recursivenomad/picoprobe-candybar/(list of files, cad)

Other CAD files:
enclosure/picoprobe-candybar.FCStd
