recursivenomad/picoprobe-candybar/pcb/picoprobe-candybar.kicad_sch

## KiCad design pcb/picoprobe-candybar.kicad_sch (2024-10-31, an earlier design)

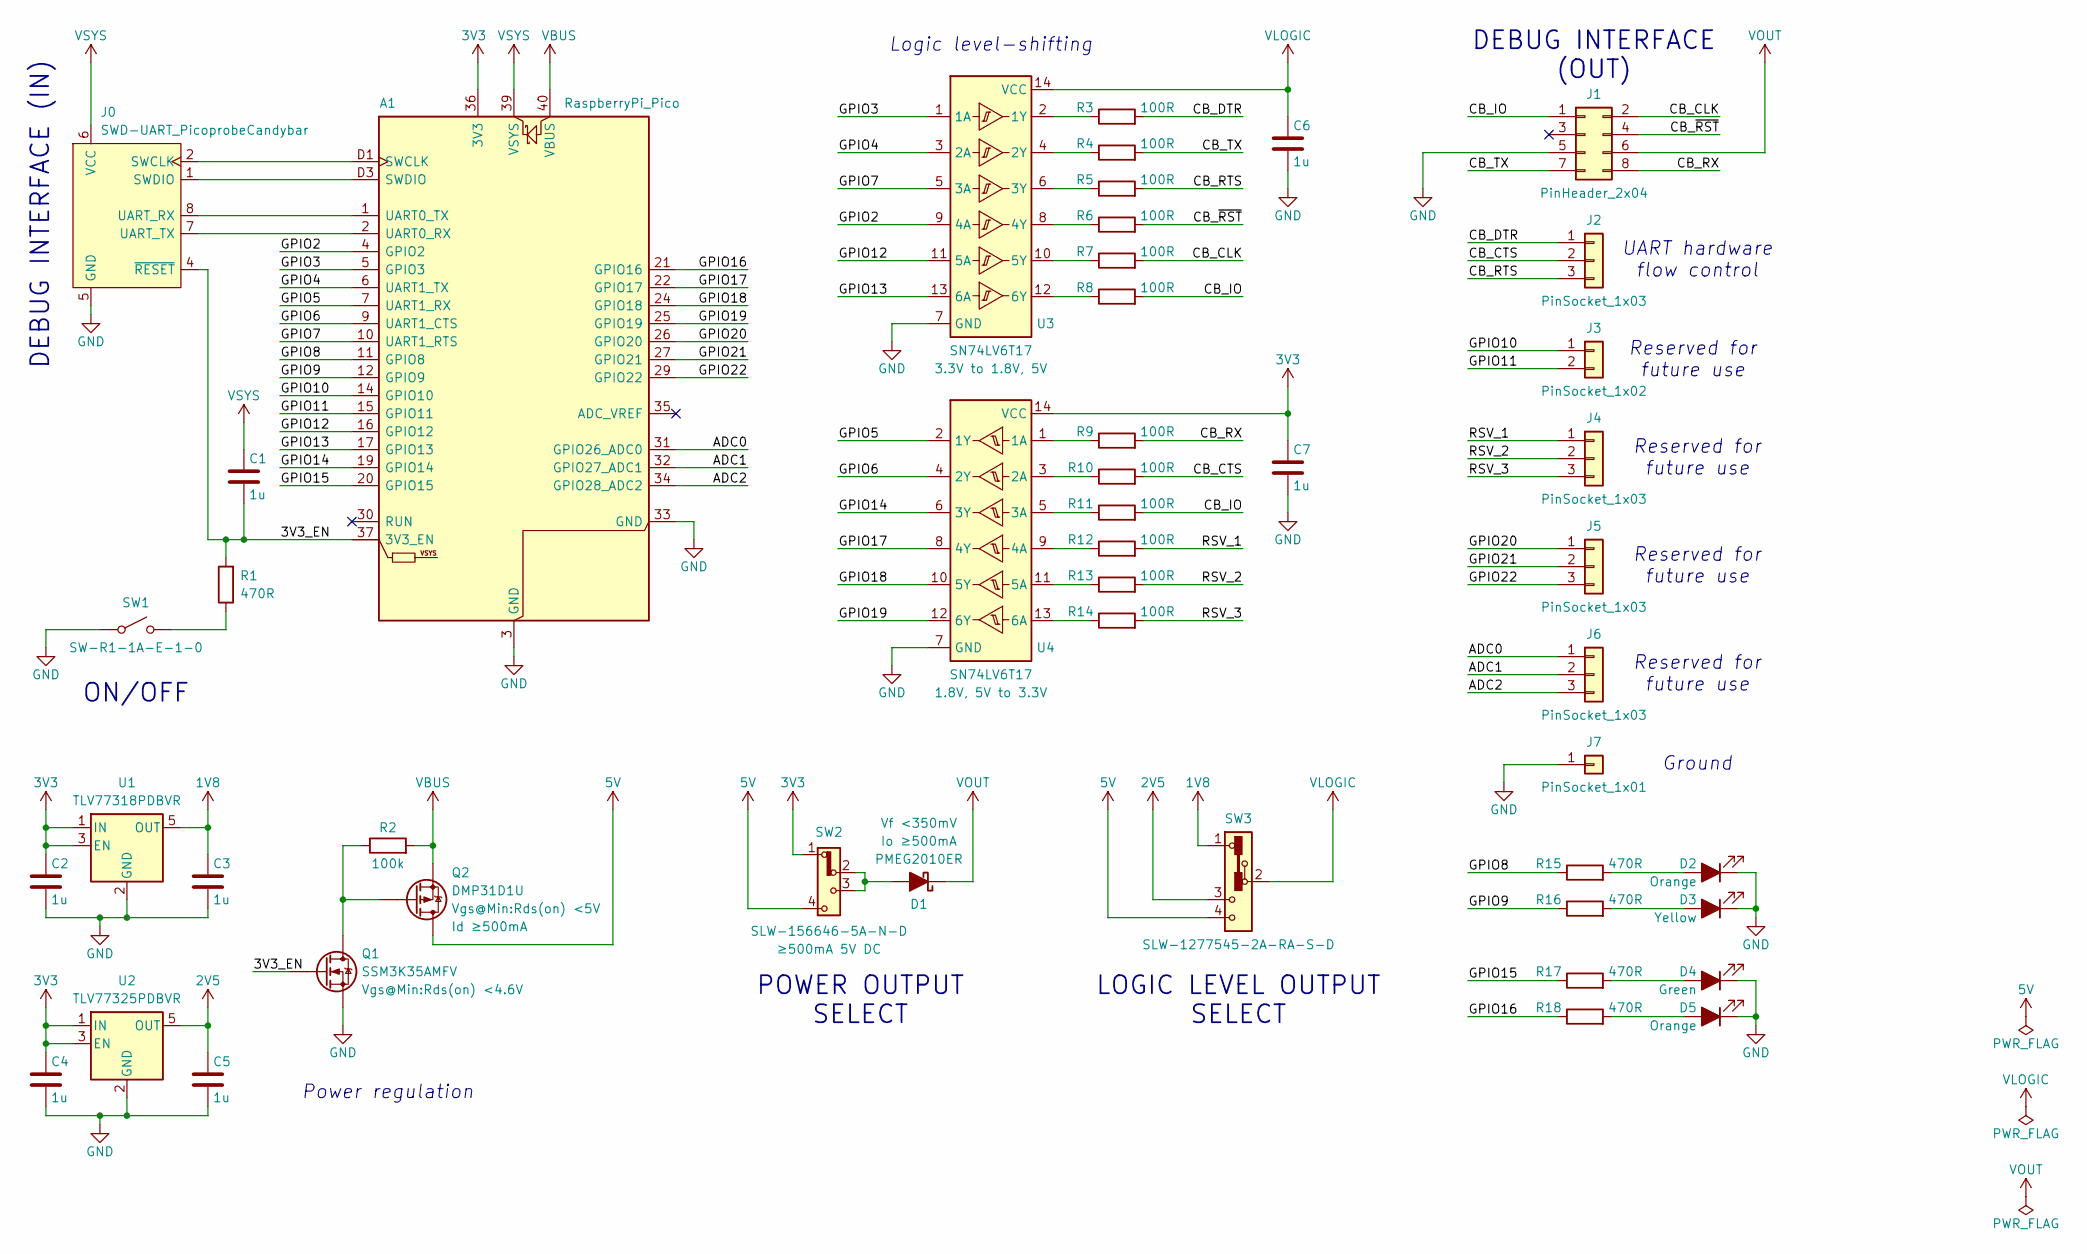
[picture p1: schematic picoprobe-candybar.kicad_sch]

Parts:
A1: RaspberryPi_Pico; RaspberryPi_Pico_Original_SMD_HandSolder
C1, C2, C3, C4, C5, C6, C7: 1u; C_0805_2012Metric_Pad1.18x1.45mm_HandSolder
D1: PMEG2010ER; Nexperia_CFP3_SOD-123W
D2, D5: Orange; LED_0805_2012Metric_Pad1.15x1.40mm_HandSolder
D3: Yellow; LED_0805_2012Metric_Pad1.15x1.40mm_HandSolder
D4: Green; LED_0805_2012Metric_Pad1.15x1.40mm_HandSolder
J0: SWD-UART_PicoprobeCandybar; SWD-UART_PicoprobeCandybar_2Rows_7Pins_P2.54mm_Polarized_Pr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
J1: PinHeader_2x04; PinHeader_2x04_P2.54mm_Vertical
J2, J4, J5, J6: PinSocket_1x03; PinSocket_1x03_P2.54mm_Horizontal
J3: PinSocket_1x02; PinSocket_1x02_P2.54mm_Horizontal
J7: PinSocket_1x01; PinSocket_1x01_P2.54mm_Horizontal
Q1: SSM3K35AMFV; SOT-723
Q2: DMP31D1U; SOT-23-3
R1, R15, R16, R17, R18: 470R; R_0805_2012Metric_Pad1.20x1.40mm_HandSolder
R2: 100k; R_0805_2012Metric_Pad1.20x1.40mm_HandSolder
R3, R4, R5, R6, R7, R8, R9, R10, R11, R12, R13, R14: 100R; R_0805_2012Metric_Pad1.20x1.40mm_HandSolder
SW1: SW-R1-1A-E-1-0; SW_Rocker_SPST_QuickConnect_P10.8mm_SW-R1-1X-E-XX-0_Retrofi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
SW2: SLW-156646-5A-N-D; SW_Slide_SP3T_Vertical_P3.2mm_CUI_SLW-156646-5A-N-D
SW3: SLW-1277545-2A-RA-S-D; SW_Slide_SP3T_Common_Horizontal_P2mm_CUI_SLW-1277545-2A-RA-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
U1: TLV77318PDBVR; SOT-23-5
U2: TLV77325PDBVR; SOT-23-5
U3, U4: SN74LV6T17; TSSOP-14_4.4x5mm_P0.65mm

Connections:
1V8: C3.1, SW3.1, U1.5 (OUT)
2V5: C5.1, SW3.3, U2.5 (OUT)
3V3: A1.36 (3V3), C2.1, C4.1, C7.1, SW2.1, U1.1 (IN), U1.3 (EN), U2.1 (IN), U2.3 (EN), U4.14 (VCC)
5V: Q2.3 (D), SW2.4, SW3.4
ADC0: A1.31 (GPIO26_ADC0), J6.1
ADC1: A1.32 (GPIO27_ADC1), J6.2
ADC2: A1.34 (GPIO28_ADC2), J6.3
CB_CLK: J1.2, R7.2
CB_CTS: J2.2, R10.2
CB_DTR: J2.1, R3.2
CB_IO: J1.1, R8.2, R11.2
CB_RTS: J2.3, R5.2
CB_RX: J1.8, R9.2
CB_TX: J1.7, R4.2
CB_~RST: J1.4, R6.2
GND: A1.3 (GND), A1.8 (GND), A1.13 (GND), A1.18 (GND), A1.23 (GND), A1.28 (GND), A1.33 (AGND), A1.38 (GND), A1.D2 (GND), C2.2, C3.2, C4.2, C5.2, C6.2, C7.2, D2.1 (K), D3.1 (K), D4.1 (K), D5.1 (K), J0.5 (GND), J1.5, J7.1, Q1.2 (S), SW1.1 (A), U1.2 (GND), U2.2 (GND), U3.7 (GND), U4.7 (GND)
GPIO2: A1.4 (GPIO2), U3.9 (4A)
GPIO3: A1.5 (GPIO3), U3.1 (1A)
GPIO4: A1.6 (GPIO4), U3.3 (2A)
GPIO5: A1.7 (GPIO5), U4.2 (1Y)
GPIO6: A1.9 (GPIO6), U4.4 (2Y)
GPIO7: A1.10 (GPIO7), U3.5 (3A)
GPIO8: A1.11 (GPIO8), R15.1
GPIO9: A1.12 (GPIO9), R16.1
GPIO10: A1.14 (GPIO10), J3.1
GPIO11: A1.15 (GPIO11), J3.2
GPIO12: A1.16 (GPIO12), U3.11 (5A)
GPIO13: A1.17 (GPIO13), U3.13 (6A)
GPIO14: A1.19 (GPIO14), U4.6 (3Y)
GPIO15: A1.20 (GPIO15), R17.1
GPIO16: A1.21 (GPIO16), R18.1
GPIO17: A1.22 (GPIO17), U4.8 (4Y)
GPIO18: A1.24 (GPIO18), U4.10 (5Y)
GPIO19: A1.25 (GPIO19), U4.12 (6Y)
GPIO20: A1.26 (GPIO20), J5.1
GPIO21: A1.27 (GPIO21), J5.2
GPIO22: A1.29 (GPIO22), J5.3
InternalPullUp_3V3_EN: A1.37 (3V3_EN), C1.2, J0.4 (~RESET), Q1.1 (G), R1.2
unnamed: A1.1 (GPIO0), J0.8 (UART_RX)
unnamed: A1.2 (GPIO1), J0.7 (UART_TX)
unnamed: A1.D1 (SWCLK), J0.2 (SWCLK)
unnamed: A1.D3 (SWDIO), J0.1 (SWDIO)
unnamed: D1.2 (A), SW2.2, SW2.3
unnamed: D2.2 (A), R15.2
unnamed: D3.2 (A), R16.2
unnamed: D4.2 (A), R17.2
unnamed: D5.2 (A), R18.2
unnamed: Q1.3 (D), Q2.1 (G), R2.1
unnamed: R1.1, SW1.2 (B)
unnamed: R3.1, U3.2 (1Y)
unnamed: R4.1, U3.4 (2Y)
unnamed: R5.1, U3.6 (3Y)
unnamed: R6.1, U3.8 (4Y)
unnamed: R7.1, U3.10 (5Y)
unnamed: R8.1, U3.12 (6Y)
unnamed: R9.1, U4.1 (1A)
unnamed: R10.1, U4.3 (2A)
unnamed: R11.1, U4.5 (3A)
unnamed: R12.1, U4.9 (4A)
unnamed: R13.1, U4.11 (5A)
unnamed: R14.1, U4.13 (6A)
RSV_1: J4.1, R12.2
RSV_2: J4.2, R13.2
RSV_3: J4.3, R14.2
VBUS: A1.40 (VBUS), Q2.2 (S), R2.2
VLOGIC: C6.1, SW3.2, U3.14 (VCC)
VOUT: D1.1 (K), J1.6
VSYS: A1.39 (VSYS), C1.1, J0.6 (VCC)

Notes on the sheet:
POWER OUTPUT SELECT
Ground
Reserved for future use
DEBUG INTERFACE (IN)
LOGIC LEVEL OUTPUT SELECT
Power regulation
ON/OFF
DEBUG INTERFACE (OUT)
Logic level-shifting
UART hardware flow control
