recursivenomad/picoprobe-candybar/firmware/src/candybar_hook.c

/* SPDX-License-Identifier: MIT-0 OR CC0-1.0 *\
\*    Authored 2024 by Peter S. Hollander    */


/*
   debugprobe calls bi_decl_config() from the top of main().
   We point to _this_ file in our CMakeLists.txt - both to add custom binary
   declarations, but also to hook into the start of execution and inject our
   own features on top of debugprobe's, without modifying its source.
*/


#include "pico_binary_license_info.h"

#include "DAP_config.h"
#include "probe_config.h"

#include "DAP.h"

#include "hardware/gpio.h"
#include "pico/binary_info.h"

#include <stdbool.h>
#include <stdint.h>


#define STR_LITERAL(x) #x
#define STR(x) STR_LITERAL(x)


#define DHCSR_DBGKEY      0xA05F
#define DHCSR_C_DEBUGEN  (1U << 0)
#define DHCSR_C_HALT     (1U << 1)


static const uint8_t HaltInjectionBuffer[] = {
        ID_DAP_Transfer,                // DAP_ProcessCommand() ID; incremented in switch()
        0x00,                           // DAP_SWD_Transfer() "Ignore DAP index" ?
        0x01,                           // DAP_SWD_Transfer() request_count
        DAP_TRANSFER_APnDP,             // DAP_SWD_Transfer() request_value
        DHCSR_C_DEBUGEN | DHCSR_C_HALT, // DAP_SWD_Transfer() data [7:0]
        0x00,                           //                    data [15:8]
        (uint8_t)(DHCSR_DBGKEY),        //                    data [23:16]
        (uint8_t)(DHCSR_DBGKEY >> 8)    //                    data [31:24]
    };


void DAP_inject_halt_callback(unsigned int gpio, unsigned long event_mask) {
    // TODO: Is this interrupt safe if another transfer is already in progress?
    // TODO: Is this interrupt safe if another interrupt occurs during it?

    // Ignore unused parameters defined by gpio_irq_callback_t typedef
    (void) gpio;
    (void) event_mask;

    uint8_t ThrowawayReceiveBuffer[DAP_PACKET_COUNT];
    DAP_ProcessCommand(HaltInjectionBuffer, ThrowawayReceiveBuffer);
}


void candybar_hook(void) {
    // These pulls will weakly influence the target circuit
    gpio_pull_down(PROBE_PIN_IRQ_RISING);
    gpio_pull_up(PROBE_PIN_IRQ_FALLING);

    gpio_set_irq_enabled_with_callback(PROBE_PIN_IRQ_RISING, GPIO_IRQ_EDGE_RISE, true, &DAP_inject_halt_callback);
    gpio_set_irq_enabled_with_callback(PROBE_PIN_IRQ_FALLING, GPIO_IRQ_EDGE_FALL, true, &DAP_inject_halt_callback);
}


void bi_decl_config(void) {

    candybar_hook();

    bi_decl(bi_1pin_with_name(PROBE_PIN_SWCLK, "PROBE SWCLK"));
    bi_decl(bi_1pin_with_name(PROBE_PIN_SWDIO, "PROBE SWDIO"));
    bi_decl(bi_1pin_with_name(PROBE_PIN_SWDI,  "PROBE SWDI" ));
    bi_decl(bi_1pin_with_name(PROBE_PIN_RESET, "PROBE RESET"));

    bi_decl(bi_1pin_with_name(PROBE_UART_TX, "PROBE UART_TX"));
    bi_decl(bi_1pin_with_name(PROBE_UART_RX, "PROBE UART_RX"));

    bi_decl(bi_1pin_with_name(PROBE_UART_CTS, "PROBE UART_CTS"));
    bi_decl(bi_1pin_with_name(PROBE_UART_RTS, "PROBE UART_RTS"));
    bi_decl(bi_1pin_with_name(PROBE_UART_DTR, "PROBE UART_DTR"));

    bi_decl(bi_1pin_with_name(PROBE_USB_CONNECTED_LED, "LED_USB_CONN"));
    bi_decl(bi_1pin_with_name(PROBE_DAP_CONNECTED_LED, "LED_DAP_CONN"));
    bi_decl(bi_1pin_with_name(PROBE_DAP_RUNNING_LED,   "LED_DAP_RUN" ));
    bi_decl(bi_1pin_with_name(PROBE_UART_TX_LED,       "LED_UART_TX" ));
    bi_decl(bi_1pin_with_name(PROBE_UART_RX_LED,       "LED_UART_RX" ));

    // picotool lists bi_decl's of each category in reverse order
    bi_decl(bi_program_feature(STR(PROBE_UART_BAUDRATE) " baud probe UART"));
    bi_decl(bi_program_feature("Activity indicator LEDs"));
    bi_decl(bi_program_feature("Probe target reset support"));

    bi_decl(bi_program_author("Firmware derived from Raspberry Pi's Debug Probe"));
    bi_decl(bi_program_author("Peter S. Hollander <recursivenomad@protonmail.com>"));

    bi_decl(bi_program_license("See repository or accompanying .TXT for complete notices"));
    bi_decl(bi_program_license("MIT-0 OR CC0-1.0, BSD-3-Clause, MIT, Apache-2.0, SunPro, OAR, BSD-4.3TAHOE, Martin-Birgmeier"));

}


#undef STR
#undef STR_LITERAL
