recursivenomad/picoprobe-candybar/(commit log)

2024-06-22 Initialize KiCad project
    KiCad 8.0.3
    [picoprobe-candybar.kicad_pcb, picoprobe-candybar.kicad_sch]
2024-06-23 Add ki-lime-pi-to-go submodule
    Ki-Lime Pi Pico 2.0.0
2024-06-23 Register Raspberry Pi Pico library
2024-06-25 Add kicad-title-block submodule
2024-06-25 Register compact-title-block
    [picoprobe-candybar.kicad_pcb, picoprobe-candybar.kicad_sch]
2024-06-30 Embrace Ki-Lime Pi Pico library name
2024-06-30 Update Ki-Lime Pi Pico to include CC0 dual license
2024-06-30 Update kicad-title-block for standardized license
2024-07-03 Add debugprobe submodule
    Debug Probe v2.0.1
2024-07-03 Create binary-equivalent build process
    Building from firmware/CMakeLists.txt should produce an identical uf2
    when compared to building debugprobe with default settings.
    The creation of a custom CMakeLists.txt and candybar_binary_config.c
    avoids touching any of the unlicensed files distributed by the
    debugprobe repository, while still giving us a starting point of
    building identical binaries.
    [candybar_binary_config.c]
2024-07-03 Add Debug Probe config override
2024-07-03 Override with definitions specific to Candybar
    - Adding target reset support
    - Using the onboard LED for USB indication
    - Applying a custom USB device name
    [board_debug_probe_config.h]
2024-07-03 Remove existing UART feature descriptions
2024-07-06 Fix Ki-Lime Pi Pico library paths
2024-07-26 Update Ki-Lime Pi Pico to 2.1.1
2024-07-26 Don't track a specific branch for Ki-Lime Pi Pico
2024-07-29 Add Raspberry Pi Pico
    [picoprobe-candybar.kicad_sch]
2024-07-29 Add IDC cable connector
    [picoprobe-candybar.kicad_sch]
2024-07-29 Add Picoprobe Candybar debugger interface
    [picoprobe-candybar.kicad_sch]
2024-07-29 Add 74AUP1T17 per Debug Probe schematic
    <https://assets.nexperia.com/documents/data-sheet/74AUP1T17.pdf>
    <https://datasheets.raspberrypi.com/debug/raspberry-pi-debug-probe-schematics.pdf>
2024-07-29 Add all supplemental Debug Probe components
    Identified by comparing against the Pico schematic
    <https://datasheets.raspberrypi.com/pico/pico-datasheet.pdf#pico-schematic>
    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
    [picoprobe-candybar.kicad_sch]
2024-07-29 Initial IDC connector layout
    [picoprobe-candybar.kicad_sch]
2024-07-29 Initial SWD pins layout
    [picoprobe-candybar.kicad_sch]
2024-07-29 Duplicate to create UART pins
    [picoprobe-candybar.kicad_sch]
2024-07-29 Reposition SWD/UART group
    [picoprobe-candybar.kicad_sch]
2024-07-29 Connect Pico & (debugger's own) debug interface
    [picoprobe-candybar.kicad_sch]
2024-07-29 ERC: Don't short VSYS/VBUS
    [picoprobe-candybar.kicad_sch]
2024-07-29 Add schottkey rectifier to match VSYS/VBUS diode
    See D1 from Pico schematic:
    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
2024-07-29 Centre diode symbol
    Technically "off-grid" to KLC, but follows convention of other diodes
2024-07-29 Add VBUS/VCC connection w/ protection diode
    Also adds power flag to accommodate ERC after diode
    (off-page for cleaner exported schematics)
    [picoprobe-candybar.kicad_sch]
2024-07-29 ERC: Replace colliding label with non-label text
    [picoprobe-candybar.kicad_sch]
2024-07-30 Update Ki-Lime Pi Pico to 2.1.2
2024-07-30 ERC: Add internal pull-up resistor for 3V3_EN pin
    [picoprobe-candybar.kicad_sch]
2024-07-30 Emphasize Raspberry Pi attribution
2024-07-30 Update title blocks to reflect unreleased state
    [picoprobe-candybar.kicad_pcb, picoprobe-candybar.kicad_sch]
2024-07-30 Nudge wire spacing
    [picoprobe-candybar.kicad_sch]
2024-07-31 Adjust GND/power positioning
    [picoprobe-candybar.kicad_sch]
2024-07-31 Nudge IDC connector wire spacing
    [picoprobe-candybar.kicad_sch]
2024-07-31 Reposition all elements
    [picoprobe-candybar.kicad_sch]
2024-07-31 Set Pico UART alternate pin assignments
    [picoprobe-candybar.kicad_sch]
2024-07-31 Change nRST pin to GPIO3
    Was previously rolling with the Debug Probe default of GPIO1, but that
    definition appears to be due to Debug Probe's limited pinout [1].
    This schematic will read easier if GPIO1 isn't shared.
    (Plus UART0 probably wouldn't have worked if this firmware needed to be
    debugged when it was shared with nRST)
    [1]: <https://github.com/raspberrypi/debugprobe/pull/123#issuecomment-1964397931>
    [picoprobe-candybar.kicad_sch]
2024-08-01 Add SP3T switch for selecting VCC source
    [picoprobe-candybar.kicad_sch]
2024-08-01 Initialize SP3T switch symbol
2024-08-01 Layout slide switch symbol
2024-08-01 Widen contact to align w/ built-in slide switch
2024-08-01 Initialize project-specific footprint directory
2024-08-01 Initialize SP3T footprint
2024-08-01 Make SP3T pin 1 rounded square
2024-08-01 Move origin to Pin 1 for THT
2024-08-01 Add silkscreen outline
2024-08-01 Set placeholder model to scaled-up slide switch
2024-08-01 Add SP3T footprint filter
2024-08-01 Add datasheet to SP3T footprint description
2024-08-01 Swap SP3T symbol for custom SW_Slide_SP3T
    [picoprobe-candybar.kicad_sch]
2024-08-01 Specify part number for SP3T switch
    [picoprobe-candybar.kicad_sch]
2024-08-01 Nudge power symbol labels to align to grid
    [picoprobe-candybar.kicad_sch]
2024-08-02 Initialize MOSFET
    [picoprobe-candybar.kicad_sch]
2024-08-02 Swap inputs 1 & 4 on SW1 for better MOSFET pos
    [picoprobe-candybar.kicad_sch]
2024-08-02 Connect VBUS MOSFET
    VBUS will still be powered over USB even when 3V3_EN is pulled low.
    This FET ensures that VBUS only delivers power to the target when 3V3 is
    supplied.
    [picoprobe-candybar.kicad_sch]
2024-08-02 Centre power selector under Pico
    [picoprobe-candybar.kicad_sch]
2024-08-02 Add datasheet to uniquely specified symbols
    [picoprobe-candybar.kicad_sch]
2024-08-02 Give D5 more room to breathe
    [picoprobe-candybar.kicad_sch]
2024-08-02 Add generic power switch
    [picoprobe-candybar.kicad_sch]
2024-08-02 Define power switch as narrow SW-R1-1A-E-1-0
    [picoprobe-candybar.kicad_sch]
2024-08-02 Hide SW2 pin numbers
    [picoprobe-candybar.kicad_sch]
2024-08-02 Initialize rocker switch custom footprint
    This one's gonna be interesting
2024-08-02 Create unconventional rocker switch SMD footprint
2024-08-02 Add placeholder model for rocker switch
    It's a hilariously scaled resistor
2024-08-02 Associate SW2 with unconventional footprint
    [picoprobe-candybar.kicad_sch]
2024-08-03 Reindex symbols
    [picoprobe-candybar.kicad_sch]
2024-08-03 Label schematic sections
    [picoprobe-candybar.kicad_sch]
2024-08-03 Change LED colours
    Green: Connected
    Orange: Controlling/Transmitting
    Yellow: Receiving
    [picoprobe-candybar.kicad_sch]
2024-08-03 Rename IDC header
    [picoprobe-candybar.kicad_sch]
2024-08-04 Update KiCad to 8.0.4
2024-08-04 Add back courtyard to rocker switch footprint
2024-08-09 Change D1 from MBR120VLSF to PMEG6010ELR
    Following suit of the more affordable VBUS protection diode found in the
    Raspberry Pi Pico 2
    <https://datasheets.raspberrypi.com/pico/pico-2-datasheet.pdf#schematic>
    [picoprobe-candybar.kicad_sch]
2024-08-09 Add Pico 2 schematic attribution
2024-08-09 Clarify substitutable component constraints
    [picoprobe-candybar.kicad_sch]
2024-08-09 Add debounce RC filter to on/off switch
    3V3_EN has a 100k pull-up.
    RT6150B-33GQW registers 0.4V as logic-low (off).
    Debounce resistor will create voltage divider:
    Vout > (Rl * Vcc) / (Rl + Rh)
    0.4V > (Rl * 5V) / (Rl + 100k)
    Rl < 8696
    Voltage at divider for Rl of 470ohm:
    Vout = Rl * Vcc / (Rl + Rh)
    Vout = 470 * 5V / (470 + 100k)
    Vout = 0.023V
    RT6150B-33GQW registers 1.2V as logic-high (on).
    Capacitance for >1ms DISCHARGE (on) debounce time:
    Vc < Vs * (e ^ (-t / (R * C)))
    (5V - 1.2V) < (5V - 0.023V) * (e ^ (-1ms / (100k * C)))
    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
    [picoprobe-candybar.kicad_sch]
2024-08-09 Schematic repositioning
    [picoprobe-candybar.kicad_sch]
2024-08-10 Fix RC filter source to use VSYS
    Also sets VSYS as a power symbol
    [picoprobe-candybar.kicad_sch]
2024-08-10 Add pull-down resistor to VBUS MOSFET
    [picoprobe-candybar.kicad_sch]
2024-08-10 Revert MOSFET pull-down resistor
    This reverts commit 6fe8bc9f0c940ba738d5339ab096eecd7118b4fd.
    [picoprobe-candybar.kicad_sch]
2024-08-10 Set switch symbol outline to 10 mils
2024-08-10 Fix VBUS MOSFET polarity
    Incorrectly used N-Channel when the design calls for P-Channel
    [picoprobe-candybar.kicad_sch]
2024-08-11 Add N-channel MOSFET to control VBUS MOSFET
    [picoprobe-candybar.kicad_sch]
2024-08-11 Add datasheet to P-channel VBUS MOSFET
    [picoprobe-candybar.kicad_sch]
2024-08-11 Hide MOSFET pin numbers
    [picoprobe-candybar.kicad_sch]
2024-08-11 Schematic section label spacing
    [picoprobe-candybar.kicad_sch]
2024-08-11 Update schematic with switch symbol's outline
    [picoprobe-candybar.kicad_sch]
2024-08-12 Add unconnected UART hardware flow control
    [picoprobe-candybar.kicad_sch]
2024-08-12 Relocate CTS/RTS to GPIO6/7
    This displaces the non-level-shifted CB_RX (which is actually a good
    thing, as now GPIO9 can be set to UART1_RX if desired)
    Also displaces the UART_RX_LED
    Leaves GPIO11 unassigned for future possible SWDOEN use
    [picoprobe-candybar.kicad_sch]
2024-08-12 Move nRESET to GPIO2
    Also swaps UART_DTR to GPIO3, logically grouping all UART pins together.
    [picoprobe-candybar.kicad_sch]
2024-08-12 Add optional hardware flow control socket
    [picoprobe-candybar.kicad_sch]
2024-08-12 Connect GPIO11 to 1x01 socket for future use
    Possible future SWDIOEN support
    [picoprobe-candybar.kicad_sch]
2024-08-12 Add current-limiting resistor to nRESET (out) line
    [picoprobe-candybar.kicad_sch]
2024-08-12 Reposition and label schematic
    [picoprobe-candybar.kicad_sch]
2024-08-12 Increase height of supply voltage labels
    [picoprobe-candybar.kicad_sch]
2024-08-12 Specify hardware flow control directionality
    [picoprobe-candybar.kicad_sch]
2024-08-14 Remove GPIO 11 socket
    Clarified possible future use of SWDIOEN is meant for internal signals
    <https://github.com/raspberrypi/debugprobe/issues/147>
    [picoprobe-candybar.kicad_sch]
2024-08-14 Use generic diode symbol (& delete custom diode)
    [picoprobe-candybar.kicad_sch]
2024-08-14 Change D1 from PMEG6010ELR to PMEG2010ER
    Also add substitutable component constraints for D1
    [picoprobe-candybar.kicad_sch]
2024-08-14 Increase component label spacing for legibility
    [picoprobe-candybar.kicad_sch]
2024-08-14 Disconnect GPIO11
    [picoprobe-candybar.kicad_sch]
2024-08-14 Remove previous level-shifter 74AUP1T17
    [picoprobe-candybar.kicad_sch]
2024-08-14 Disconnect GPIO9
    UART_RX shouldn't need a redundant non-shifted input
    [picoprobe-candybar.kicad_sch]
2024-08-14 Move UART_RX LED to GPIO9
    [picoprobe-candybar.kicad_sch]
2024-08-14 Isolate interface GPIO in prep for level-shifters
    [picoprobe-candybar.kicad_sch]
2024-08-14 Rearrange & simplify schematic
    [picoprobe-candybar.kicad_sch]
2024-08-14 Swap UART LED schematic hierarchy
    [picoprobe-candybar.kicad_sch]
2024-08-14 Add MicroPak to NC7WZ17 footprint filter
2024-08-14 Create mirrored NC7WZ17
    GND/VCC and labels kept in the same spot
2024-08-14 Add logic level-shifting array
    [picoprobe-candybar.kicad_sch]
2024-08-14 Alighn endpoint I/O to schematic right
    [picoprobe-candybar.kicad_sch]
2024-08-14 Add constraint to bottom-most level-shifter
    [picoprobe-candybar.kicad_sch]
2024-08-15 Add SLW-1277545-2A-RA-S-D switch symbol
    Uses placeholder 3D model
2024-08-16 Add logic level output select switch
    Connects to to-be-implemented 2V5 and 1V8 power nets
    [picoprobe-candybar.kicad_sch]
2024-08-16 Fix input logic to use 3V3 source
    [picoprobe-candybar.kicad_sch]
2024-08-16 Move resistors to external side of level-shifters
    [picoprobe-candybar.kicad_sch]
2024-08-16 Change NC7WZ17 to SN74LV6T17
    Previous buffer did not have a wide enough level translation range.
    Also, turns out this'll be cheaper at low-volume orders. Nice.
    [picoprobe-candybar.kicad_sch]
2024-08-16 Reposition and add 1.8V & 2.5V regulators
    [picoprobe-candybar.kicad_sch]
2024-08-16 Reposition schematic to improve spacing
    [picoprobe-candybar.kicad_sch]
2024-08-16 Change on/off cap to 1u
    Already have 1u on the board now for regulators, and this gets the
    debounce filtering above "the" 20ms threshold.
    <https://www.eejournal.com/article/ultimate-guide-to-switch-debounce-part-4/>
    [picoprobe-candybar.kicad_sch]
2024-08-16 Use 1uF caps for decoupling too
    Saves adding an extra cap value to the BOM
    [picoprobe-candybar.kicad_sch]
2024-08-16 Hide 3V3_EN junction due to internal pull-up
    [picoprobe-candybar.kicad_sch]
2024-08-17 Directly expose GPIO10/11
    Thinking these could make good HW interrupt pins, like physical
    breakpoints
    [picoprobe-candybar.kicad_sch]
2024-08-17 Repositioning & spacing
    [picoprobe-candybar.kicad_sch]
2024-08-17 Expose GPIO17-19 as level-shifted input
    Hoping to implement these as level-shifted sigrok digital inputs someday
    See here for Picoprobe sigrok inspiration:
    <https://github.com/pico-coder/sigrok-pico>
    <https://github.com/perexg/picoprobe-sump/tree/logic-analyzer>
    <https://github.com/rgrr/yapicoprobe/blob/master/doc/sigrok.adoc>
    [picoprobe-candybar.kicad_sch]
2024-08-17 Directly expose GPIO20-22
    Additional possible future sigrok digital inputs (not level-shifted)
    [picoprobe-candybar.kicad_sch]
2024-08-17 Directly expose ADC0-2 for future use
    Also with hopes of future sigrok implementation
    [picoprobe-candybar.kicad_sch]
2024-08-17 Expose additional ground pin
    For future possible use with sigrok logic analyzer without having to
    plug in candybar interface for GND reference
    [picoprobe-candybar.kicad_sch]
2024-08-17 Date schematic
    [picoprobe-candybar.kicad_sch]
2024-08-17 Re-place internal pull-up for export rendering
    [picoprobe-candybar.kicad_sch]
2024-08-18 Prepare for 0.1.0 pre-release & add BUILDING.md
    [picoprobe-candybar.kicad_sch]
2024-08-18 Update version info for development
    [picoprobe-candybar.kicad_sch]
2024-08-18 Update schematic annotations
    [picoprobe-candybar.kicad_sch]
2024-08-18 Associate footprints
    [picoprobe-candybar.kicad_sch]
2024-08-18 Remove board keepout area from rocker switch
    Was originally planning to have it nestle into a void on the board, but
    with how I'm thinking of stacking it below the Pico it'll need to rest
    on the board like a typical SMD component. It'll be interesting.
2024-08-18 Expand courtyard around rocker switch pins
2024-08-18 Relocate rocker switch origin to exterior surface
    Might make board layout alongside MCAD easier.
2024-08-18 Update PCB title block for development
    [picoprobe-candybar.kicad_pcb]
2024-08-18 Reduce pad size of horizontal slide switch
    Previous size was creating DRC errors due to mounting hole dimensions
2024-08-18 Add rough silkscreen outline to rocker switch
2024-08-18 Mirror rocker switch footprint
    [picoprobe-candybar.kicad_sch]
2024-08-28 Define empty interrupt for GPIO10/11
2024-09-01 Add target halt command injection on interrupt
    Buffer data extrapolated from:
    - OpenOCD source
    - <https://developer.arm.com/documentation/ddi0419/e/>
    - <https://www.silabs.com/documents/public/application-notes/an0062.pdf>
    - Using a logic analyzer until manually identifying the halt command
2024-09-01 Label interrupt pins
    [picoprobe-candybar.kicad_sch]
2024-10-30 Comment regarding interrupt safety
2024-10-31 Set opposite pull-up/pull-down on IRQ GPIO
    To prevent triggering when floating
    [candybar_hook.c]
2025-05-17 Initialize .FCStd
    [picoprobe-candybar.FCStd]
2025-05-17 Instantiate parametric STEP/VRML export structure
    [picoprobe-candybar.FCStd]
2025-05-18 Populate vCable spreadsheet variables
    [picoprobe-candybar.FCStd]
2025-05-19 Restructure parametric element naming
    [picoprobe-candybar.FCStd]
2025-05-19 Create Cable_Plug_Base model
    [picoprobe-candybar.FCStd]
2025-05-19 Create Cable_Plug_Cap model
    [picoprobe-candybar.FCStd]
2025-05-19 Create Cable_Wires
    [picoprobe-candybar.FCStd]
2025-05-19 Restructure & rename hierarchies for export
    [picoprobe-candybar.FCStd]
2025-05-19 Initialize keyed PinHeader model structure
    [picoprobe-candybar.FCStd]
2025-05-19 Reposition IDSD model for centred footprint origin
    [picoprobe-candybar.FCStd]
2025-05-19 Fix "MissingPinNumber" ID
    [picoprobe-candybar.FCStd]
2025-05-19 Create PinHeader_2x04_Body
    [picoprobe-candybar.FCStd]
2025-05-19 Create PinHeader_2x04
    [picoprobe-candybar.FCStd]
2025-05-19 Add hole to header Pin 5 location
    [picoprobe-candybar.FCStd]
2025-05-19 Add header VRML export union
    [picoprobe-candybar.FCStd]
2025-05-19 Give VRMLs standard name
    KiCad StepUp will export based on VRML export name
    [picoprobe-candybar.FCStd]
2025-07-24 Re-commit .FCStd for graceful recomputation
    [picoprobe-candybar.FCStd]
2025-07-24 Fix VRML header colours by recreating fusion
    [picoprobe-candybar.FCStd]
2025-07-25 Update Plug Cap to more closely reflect real part
    [picoprobe-candybar.FCStd]
2025-07-25 Add pin holes & set VRML colours for export
    [picoprobe-candybar.FCStd]
2025-07-25 Create draft clones to preserve VRML colours
    [picoprobe-candybar.FCStd]
